zevrozman/DIY-Arduino-Based-Meteorological-station/pdfs/NodeMCU-ESP32s pinout.pdf

## Pins on breadboard

# Actual marks on the board

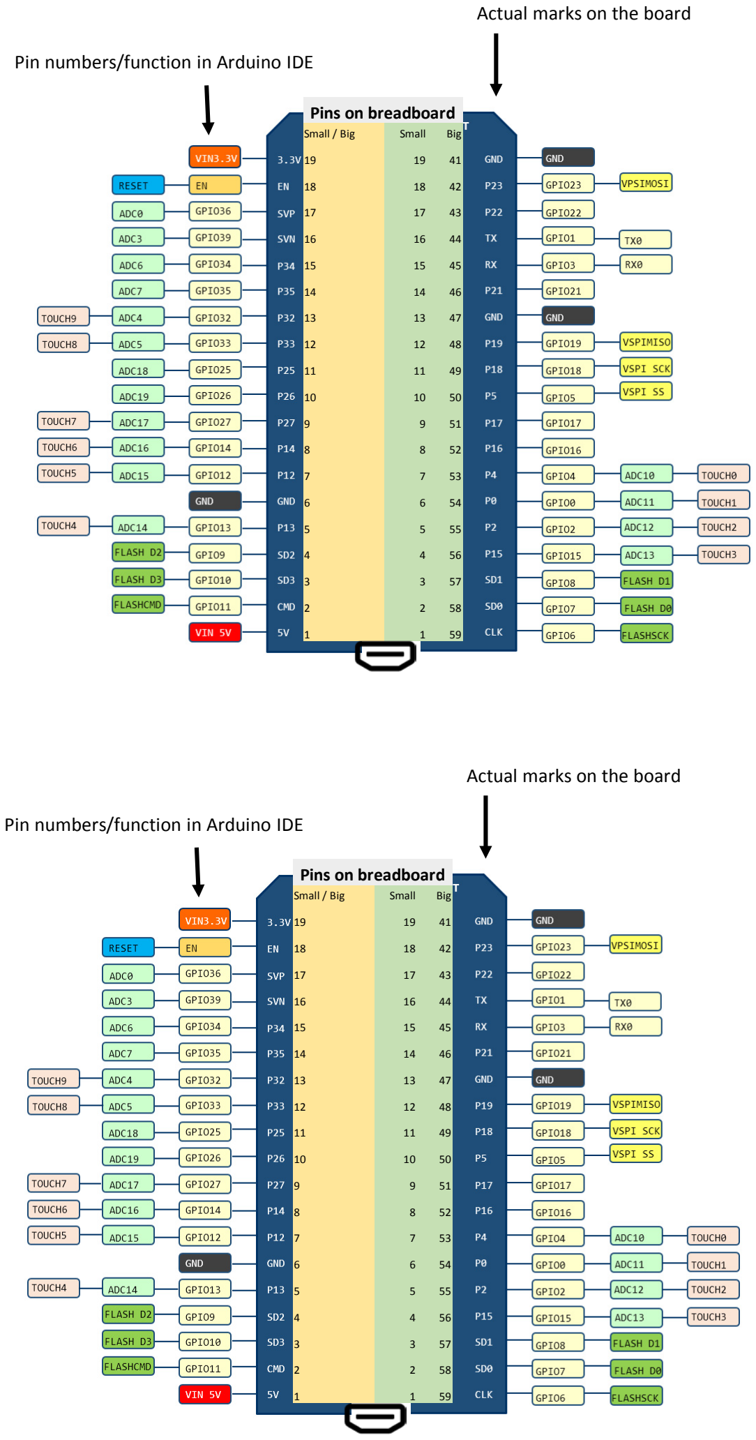
[picture p1: page 1]

Small / Big | Small | Big
19 | 19 | 41
18 | 18 | 42
17 | 17 | 43
16 | 16 | 44
15 | 15 | 45
14 | 14 | 46
13 | 13 | 47
12 | 12 | 48
11 | 11 | 49
10 | 10 | 50
9 | 9 | 51
8 | 8 | 52
7 | 7 | 53
6 | 6 | 54
5 | 5 | 55
4 | 4 | 56
3 | 3 | 57
2 | 2 | 58
1 | 1 | 59

# Pin numbers/function in Arduino IDE

## Pins on breadboard

Small / Big | Small | Big
19 | 19 | 41
18 | 18 | 42
17 | 17 | 43
16 | 16 | 44
15 | 15 | 45
14 | 14 | 46
13 | 13 | 47
12 | 12 | 48
11 | 11 | 49
10 | 10 | 50
9 | 9 | 51
8 | 8 | 52
7 | 7 | 53
6 | 6 | 54
5 | 5 | 55
4 | 4 | 56
3 | 3 | 57
2 | 2 | 58
1 | 1 | 59

# Actual marks on the board

# Pin numbers/function in Arduino IDE
