zevrozman/DIY-Arduino-Based-Meteorological-station/pdfs/The Solar radiation Sensor.pdf

The Solar radiation Sensor

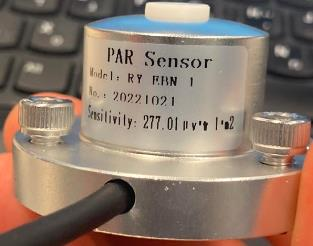
[picture p2: figure]

The Radiation sensor rational:

the code gives us options

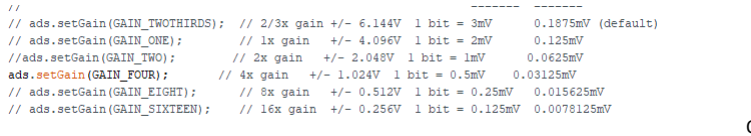
[picture p3: figure]

Our
sensor: works on 277µV to W/m2

GAIN_FOUR is within our desired range (+/- 1.024V) (Ithink we could have chosen another “Gain”and just followed accordingly in the calculation )

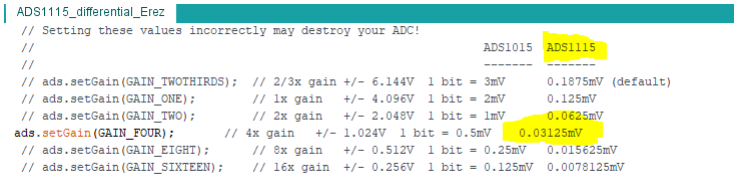
[picture p4: figure]

1 bit=0.03125mV

0.277µV =1w/m2

In the serial monitor we are receiving a reading of:

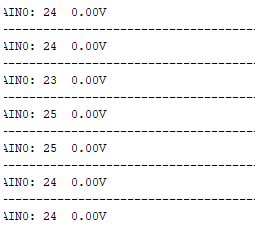
[picture p5: figure]
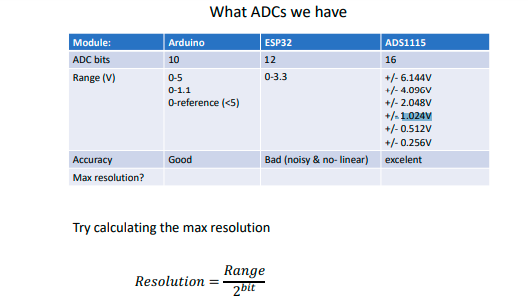
[picture p6: figure]

We use the ADS1115 because it is 16 bits and can increase our resolution significantly and fits the 1.024V from GAIN_FOUR.

See in code calculation for Voltage reading to W/m2→MJ/m2*day:

rN=((results*0.03125)/0.277) *86400/1000000

(where “results” is the Voltage output when the parameters above are used in the code,

((results*0.03125)/0.277) converts voltage to W/m2

And *86400/1000000 converts to MJ/m2*day
