zevrozman/DIY-Arduino-Based-Meteorological-station/docs/equations.md

# Equations test

## My first LaTeX equation

$$
ET_0 = \frac{\Delta R_n + 0.5 VPD \cdot U_2}{2.45[\Delta + 0.067 (1+0.33 U_2) }
$$

Now an image

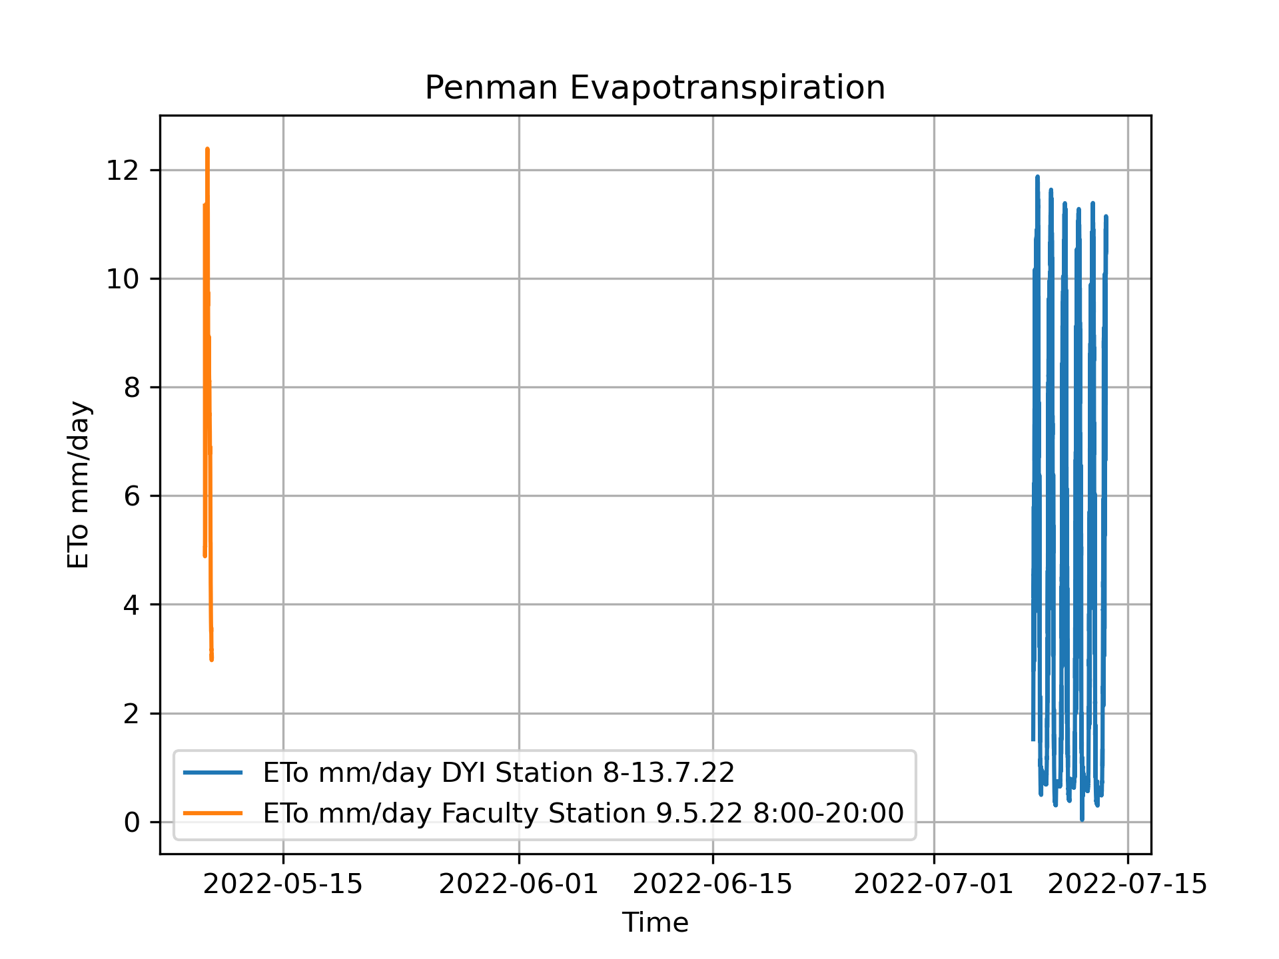
[picture p7: images/Comparing Penman Evapotranspiration.png]
