zevrozman/DIY-Arduino-Based-Meteorological-station/pdfs/Thingspeak Graphs of live uploads from Sensors.pdf

Thingspeak Graph of live uploads

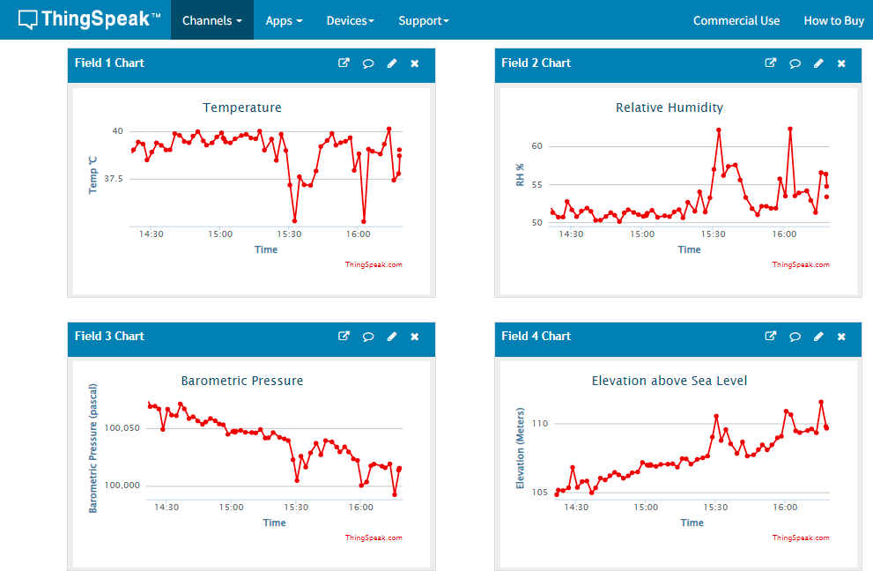
[picture p8: figure]

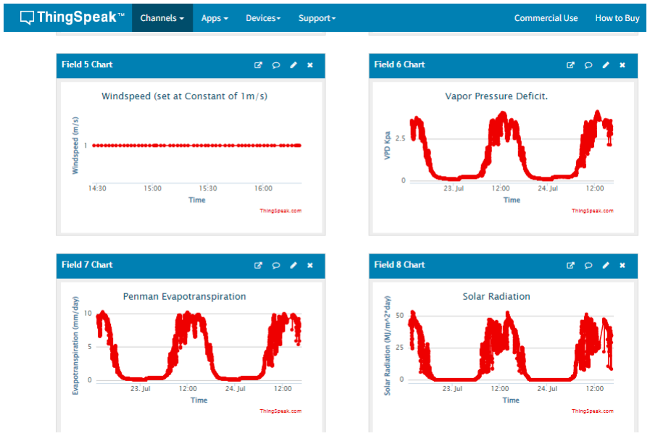
[picture p9: figure]
