zevrozman/DIY-Arduino-Based-Meteorological-station/pdfs/Calculation of Evapotranspiration and reference.pdf

Calculating Evapotranspiration

Done according to the following equation circled in yellow. Notice that this simplified equation assumes what is highlighted in Green (regarding albedo, resistance, and crop height):Also in our code we set Kc (the crop coefficient to =1 but should be adjusted accooridng to specific crop and physiological age coefficient. The Units needed for each variable are shown in red highlight. So for instance the Solar radiation gives us readings in W/m2 (after calibration of mVs). We must convert this to MJ/ m2* day (*seconds in a day and /by 10^6 joules per megajoule).

Penman Monteith Evapotranspiration calculation ( https://link.springer.com/book/10.1007/978-3-319-46116-8 (chapters 5,9, (https://link.springer.com/book/10.1007/978-3-319-46116-8%20(chapters%20%205) 10)

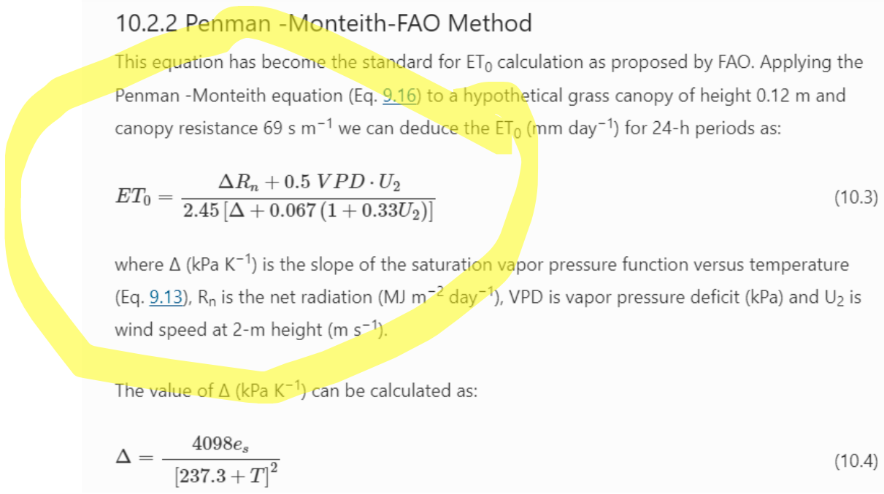
[picture p10: figure]
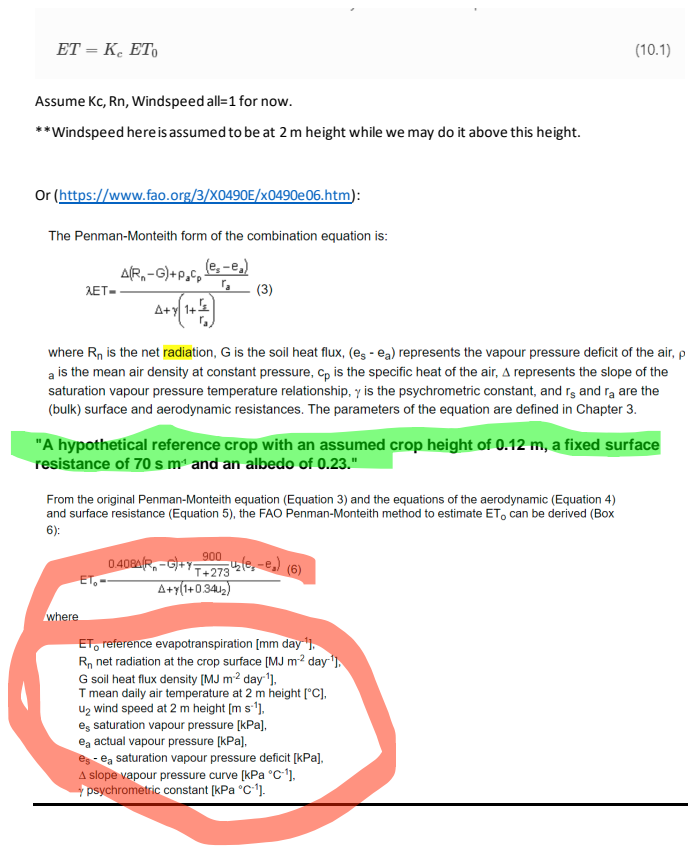
[picture p11: page 2]

Assume Kc, Rn, Windspeed all=1 for now.

**Windspeed here is assumed to be at 2 m height while we may do it above this height.

Or (https://www.fao.org/3/X0490E/x0490e06.htm):

"A hypothetical reference crop with an assumed crop height of 0.12 m, a fixed surface
resistance of 70 s m⁻¹ and an albedo of 0.23."
