zevrozman/DIY-Arduino-Based-Meteorological-station/pdfs/Meteorology station Hardwiring.pdf

Meteorology station Hardwiring.

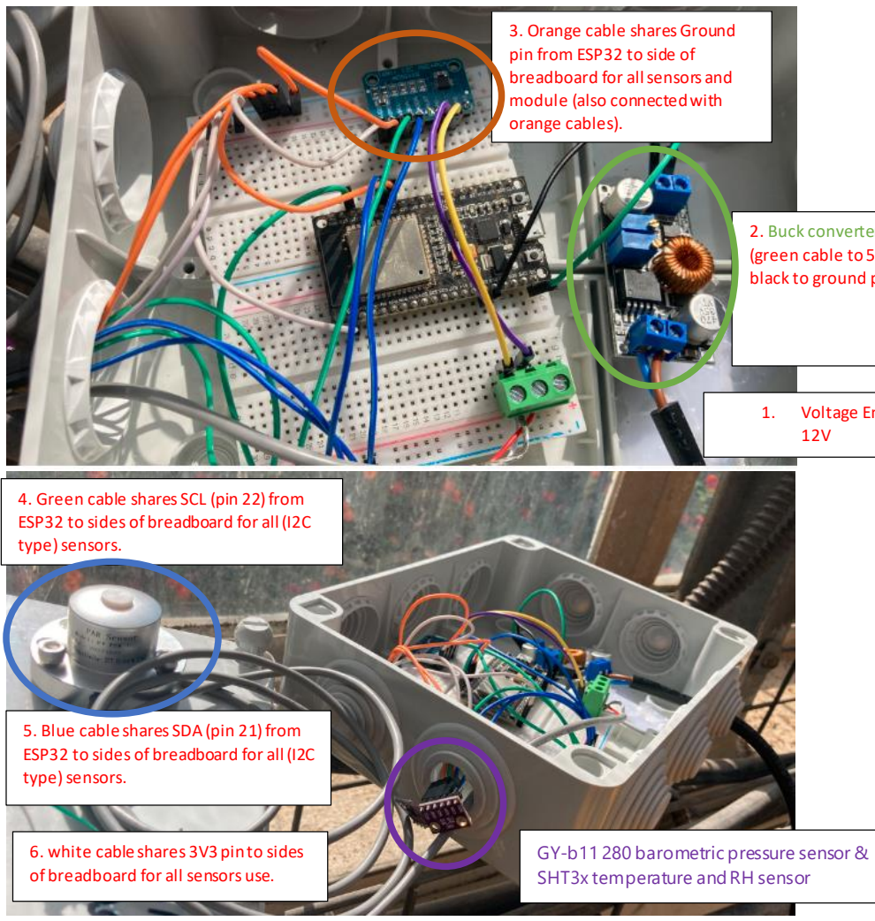
[picture p13: figure]
3. Orange cable shares Ground pin from ESP32 to side of breadboard for all sensors and module (also connected with orange cables).; 4. Green cable shares SCL (pin 22) from; type) sensors.; 5. Blue cable shares SDA (pin 21)from; 6. white cable shares 3V3 pin to sides of breadboard for all sensors use.; GY-b11 280 barometric pressure sensor &; SHT3x temperature and RH sensor

Caption:

- Voltage enters the buck converter as 12V where is set to 5V as it exits and is attached to the green cable to 5v on the esp32 and black cable to ground.
- Top image- 3v3 (white cable is attached to periphery of breadboard extending voltage to there, where all sensors 3v3 connection is to. Orange is similarly connected for Ground for all sensors. SCL is green (pin 22) and SDA is blue (pin 21)
- The radiation sensor- purple cable to A0 and yellow to A1 of the ADS1115 module ( checks differential voltage between the two).
1. Voltage Enters at
12V
2. Buck converter setat output of 5V (green cable to 5V pin on ESP32 and black to ground pin)

ESP32 to sides of breadboard for all (I2C

ESP32 to sides of breadboard for all (I2C
